74hc595/Starburst-One/board/alpha.kicad_pcb

## KiCad design board/alpha.kicad_pcb (2016-12-27)

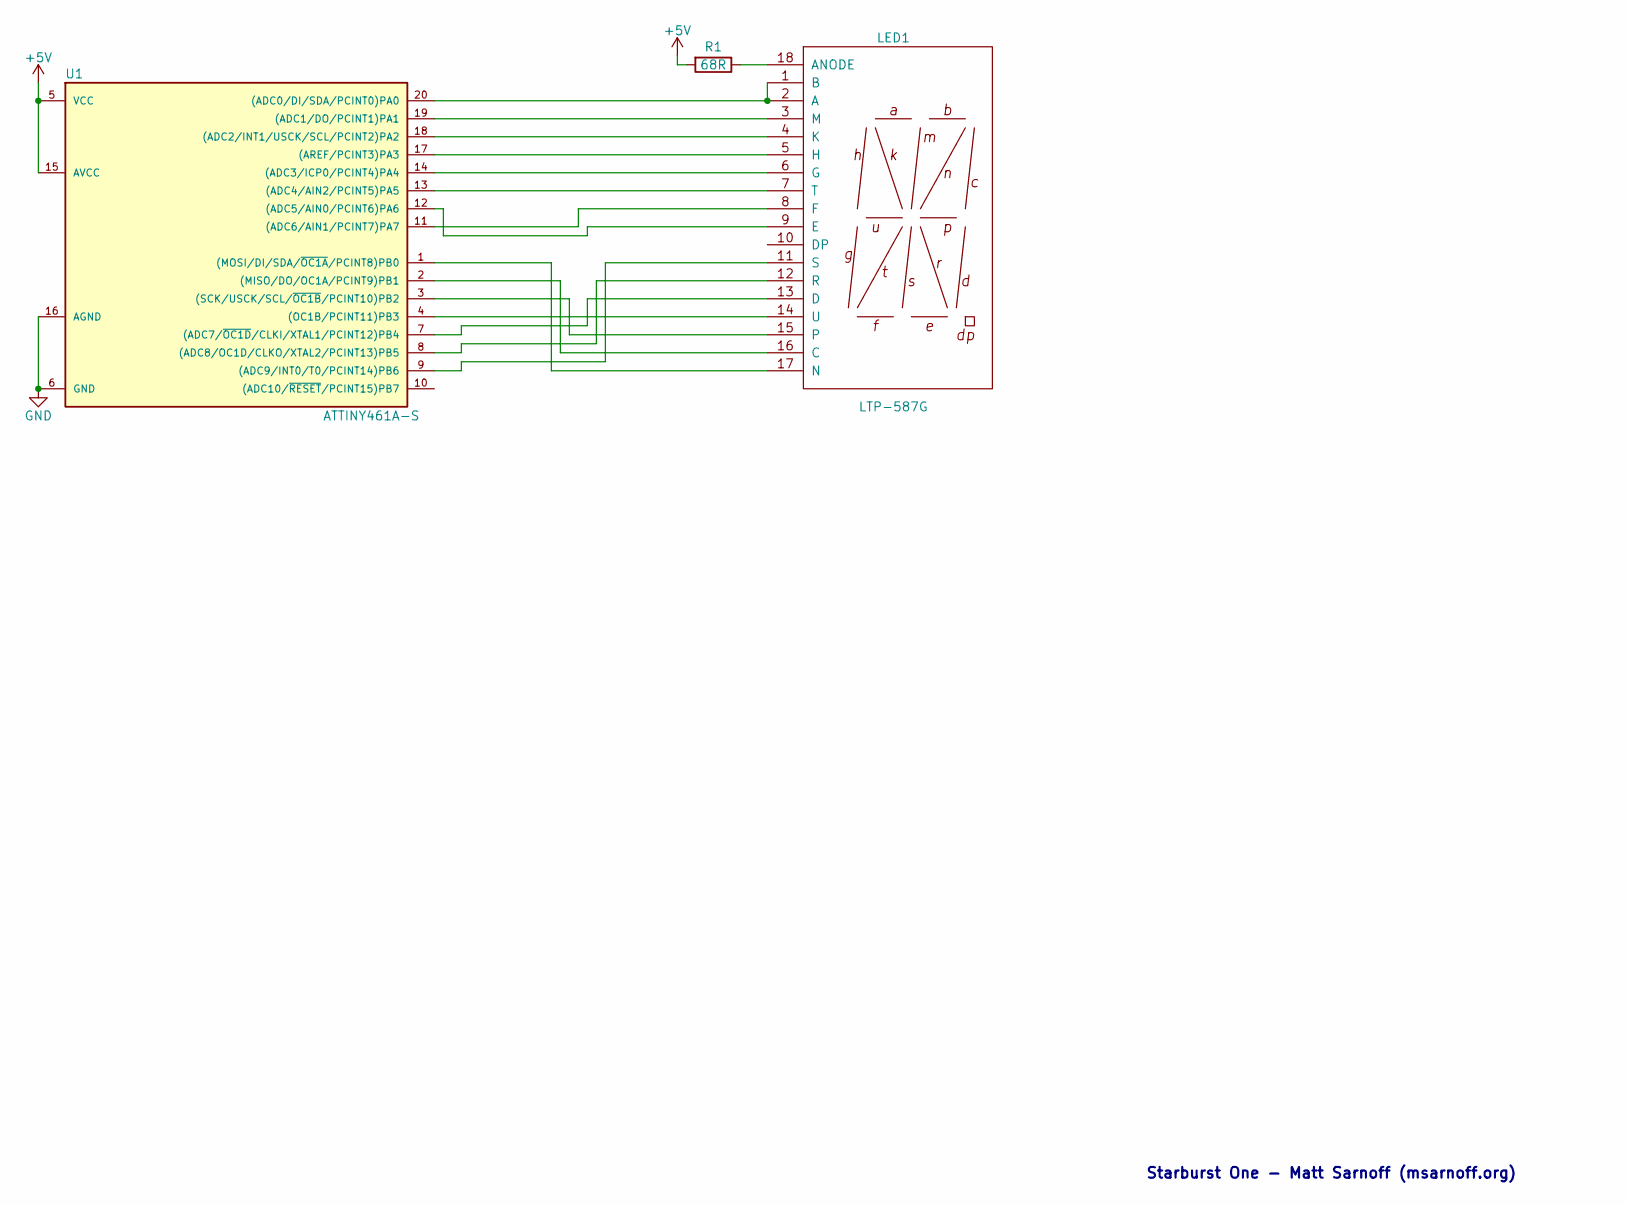
[picture p2: schematic alpha.sch]

Parts:
LED1: LTP-587G; DIP-18_Flipped_W12.7mm
R1: 68R; R_1206_HandSoldering
U1: ATTINY461A-S; SOIC-20W_7x12.8mm_Pitch1.27mm

Connections:
+5V: R1.2, U1.5 (VCC), U1.15 (AVCC)
GND: U1.6 (GND), U1.16 (AGND)
unnamed: LED1.1 (B), LED1.2 (A), U1.20 ((ADC0/DI/SDA/PCINT0)PA0)
unnamed: LED1.3 (M), U1.19 ((ADC1/DO/PCINT1)PA1)
unnamed: LED1.4 (K), U1.18 ((ADC2/INT1/USCK/SCL/PCINT2)PA2)
unnamed: LED1.5 (H), U1.17 ((AREF/PCINT3)PA3)
unnamed: LED1.6 (G), U1.14 ((ADC3/ICP0/PCINT4)PA4)
unnamed: LED1.7 (T), U1.13 ((ADC4/AIN2/PCINT5)PA5)
unnamed: LED1.8 (F), U1.11 ((ADC6/AIN1/PCINT7)PA7)
unnamed: LED1.9 (E), U1.12 ((ADC5/AIN0/PCINT6)PA6)
unnamed: LED1.11 (S), U1.9 ((ADC9/INT0/T0/PCINT14)PB6)
unnamed: LED1.12 (R), U1.8 ((ADC8/OC1D/CLKO/XTAL2/PCINT13)PB5)
unnamed: LED1.13 (D), U1.7 ((ADC7/~OC1D~/CLKI/XTAL1/PCINT12)PB4)
unnamed: LED1.14 (U), U1.4 ((OC1B/PCINT11)PB3)
unnamed: LED1.15, U1.3 ((SCK/USCK/SCL/~OC1B~/PCINT10)PB2)
unnamed: LED1.16 (C), U1.2 ((MISO/DO/OC1A/PCINT9)PB1)
unnamed: LED1.17 (N), U1.1 ((MOSI/DI/SDA/~OC1A~/PCINT8)PB0)
unnamed: LED1.18 (ANODE), R1.1

Notes on the sheet:
Starburst One - Matt Sarnoff (msarnoff.org)

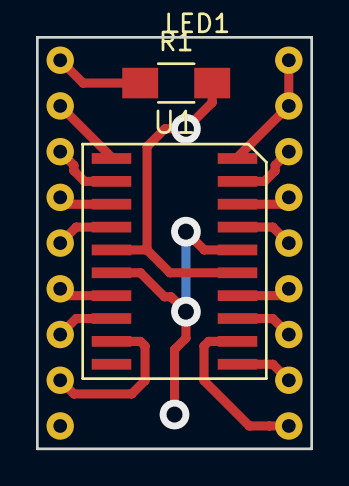
[picture p3: board alpha.kicad_pcb from above]

Board: 2 copper layers, 15.2 x 22.9 mm, 3 parts (0 on the bottom side), 18 nets.
